Safecast/SolarcastNano/README.md

# Solarcast Nano

SCNano-1.0          Original Design files for Solarcast Nano 1.0 (PCB in Altium, Mechanical in Alibre)
