Safecast/SolarcastNano/step out/SCNano-Main3.DXF

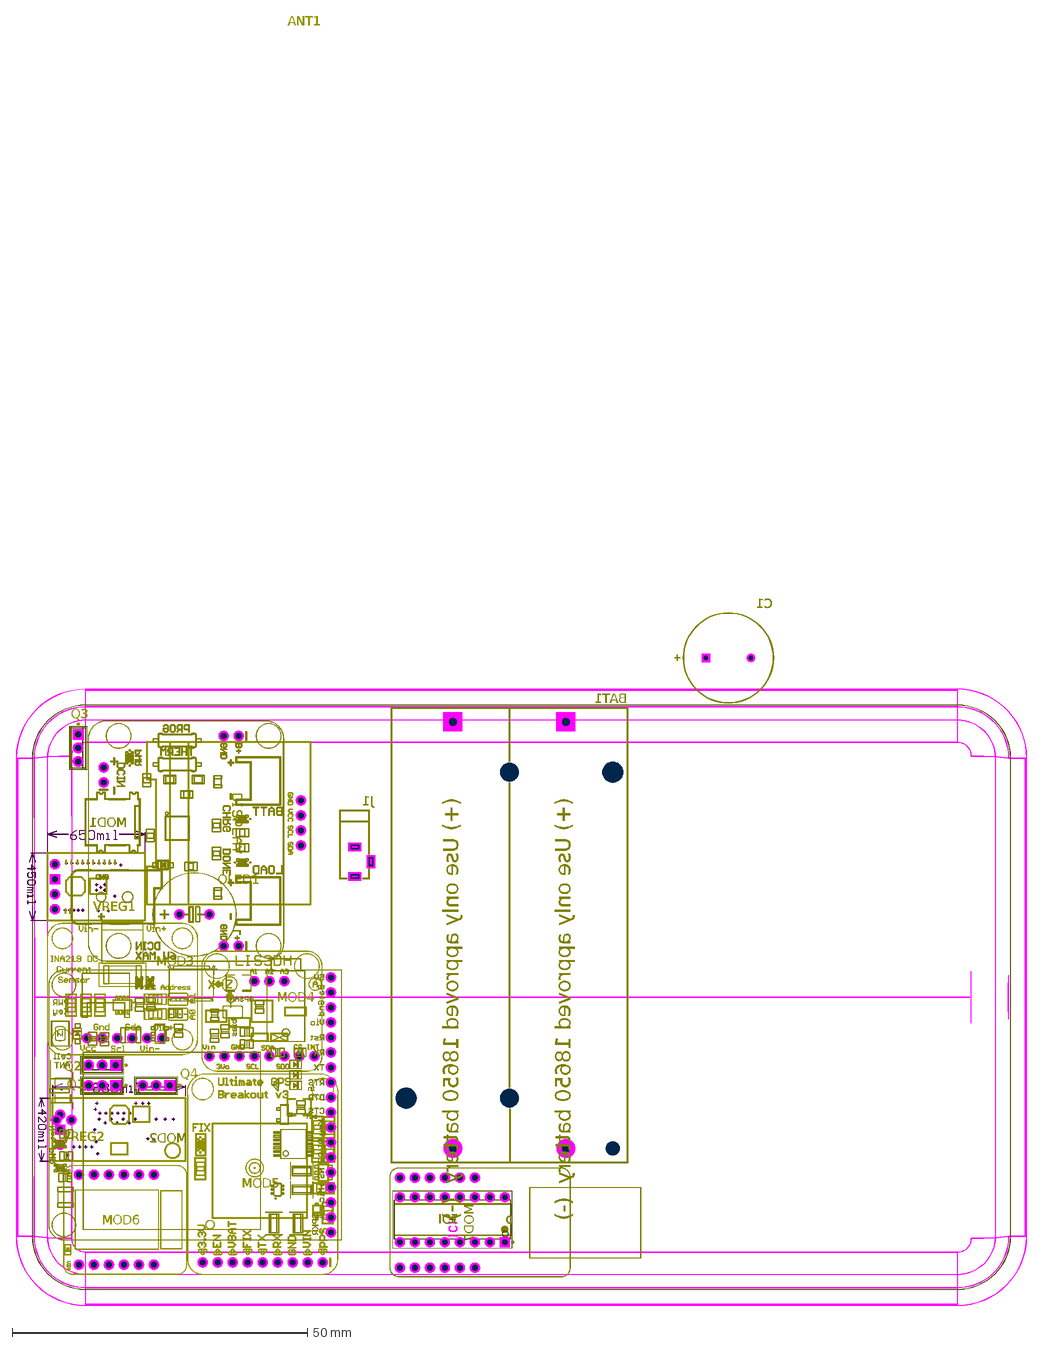
[picture p1: CAD file, 2017-12-16]
step out/SCNano-Main3.DXF
MOD7
MOD6
OLED1
VREG2
VREG1
Q4
Q3
Q2
Q1
MOD5
MOD3
MOD1
J1
IC1
(+) Use only approved 18650 battery (-)
BAT1
ANT1
MOD4
MOD2
C1
