Safecast/SolarcastNano/step/Voltatic/1.1W_6V_113x89mm_ASSEMBLY_CURRENT_2017_7_6.stp

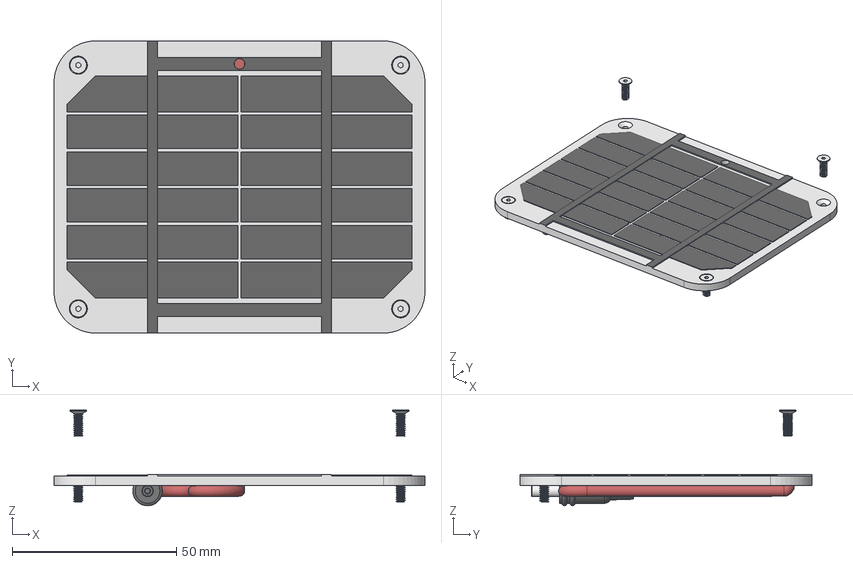
[picture p2: CAD file, 2017-12-16]
step/Voltatic/1.1W_6V_113x89mm_ASSEMBLY_CURRENT_2017_7_6.stp
113.0 x 89.0 x 29.1 mm
1.1W 6V 113x89mm PANEL CURRENT 2017 7 6
4-40 8mm SS316 Panel Screw x 4
3.2mm Wire (2 Bends)
M3511 Plug
