Safecast/SolarcastNano/step out/AD Base/GA Mount Plate.dxf

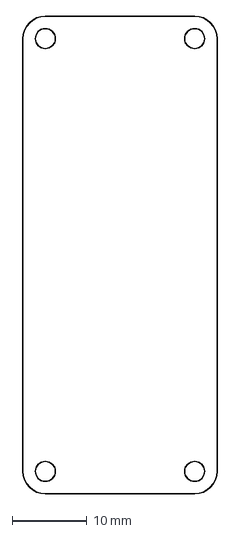
[picture p3: CAD file, 2017-12-16]
step out/AD Base/GA Mount Plate.dxf
26.0 x 64.0 mm
