Safecast/SolarcastNano/step out/CP1/SCNano-GeigCover.step

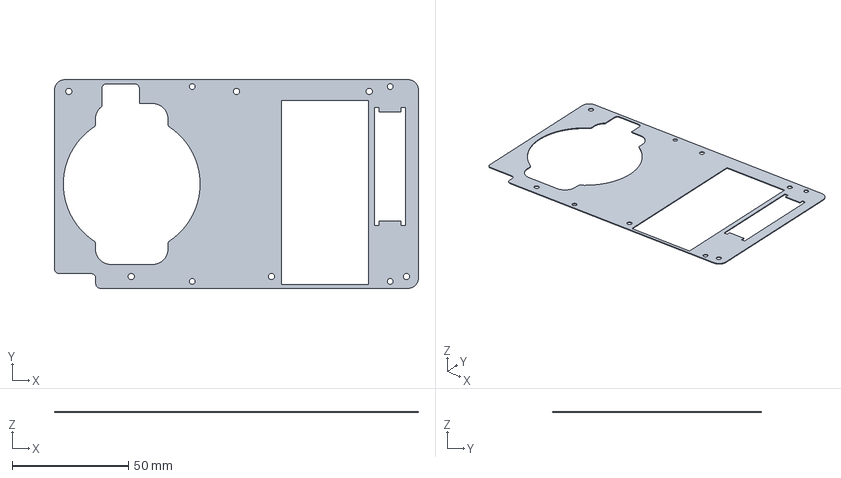
[picture p4: CAD file, 2017-12-16]
step out/CP1/SCNano-GeigCover.step
156.3 x 89.6 x 0.411 mm
