Safecast/SolarcastNano/step out/GB1/SCNano-GeigBase.step

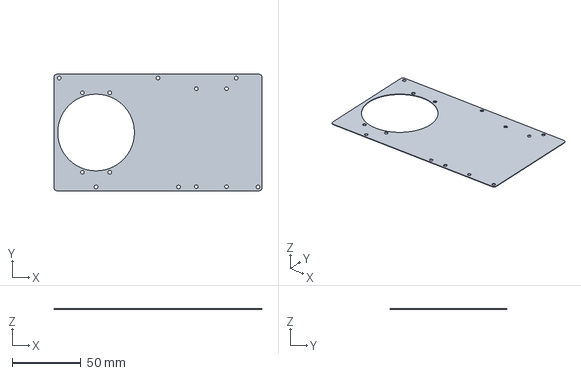
[picture p5: CAD file, 2017-12-16]
step out/GB1/SCNano-GeigBase.step
151.8 x 85.1 x 0.411 mm
