Safecast/SolarcastNano/step out/Rev A Drawings/Geiger Cover A.dxf

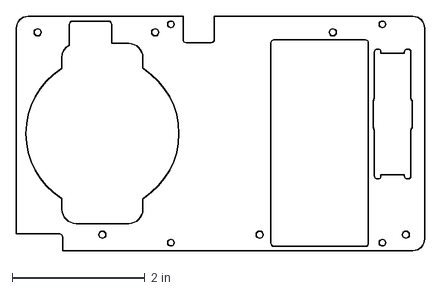
[picture p6: CAD file, 2017-12-16]
step out/Rev A Drawings/Geiger Cover A.dxf
6.15 x 3.53 in
