Safecast/SolarcastNano/step out/SCNano-GeigBase2.step

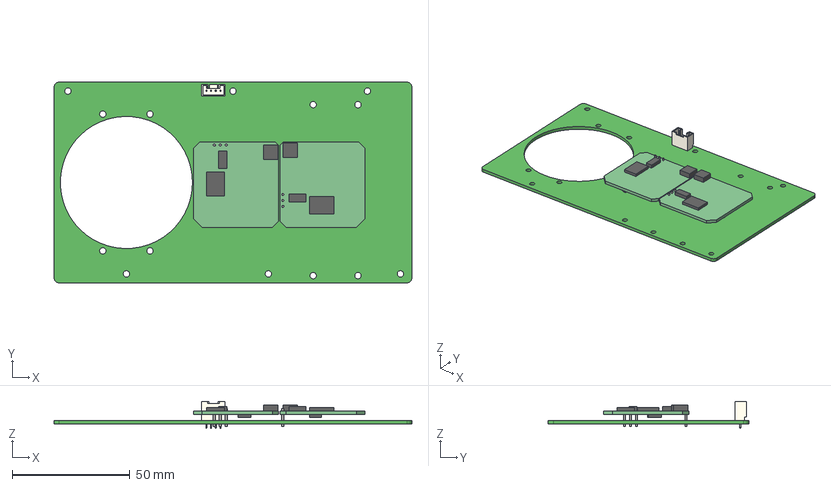
[picture p7: CAD file, 2017-12-16]
step out/SCNano-GeigBase2.step
151.8 x 85.1 x 11.6 mm
BoardGBase2
NSTech_1125S-4P
Extruded x 10
