Safecast/SolarcastNano/step/CUI PJ-031CH/pj-031ch.stp

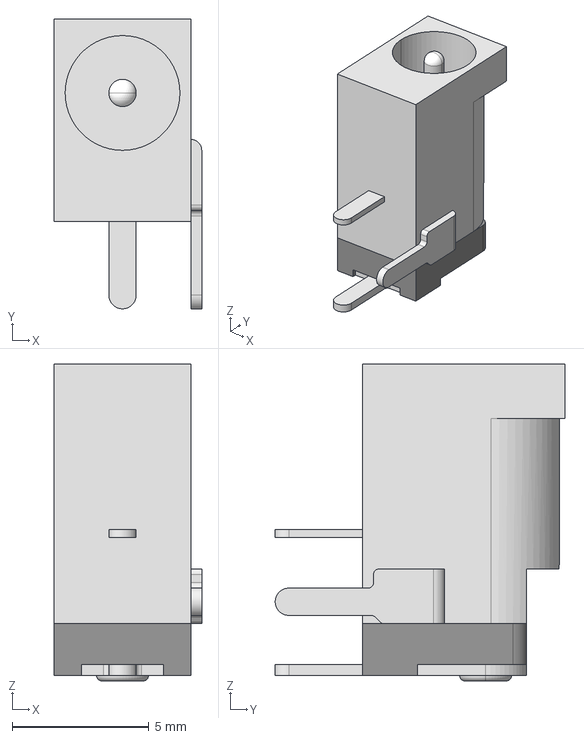
[picture p8: CAD file, 2017-12-16]
step/CUI PJ-031CH/pj-031ch.stp
5.40 x 10.6 x 11.6 mm
