Safecast/SolarcastNano/step/Headers/c-3-644457-5-e1-3d.stp

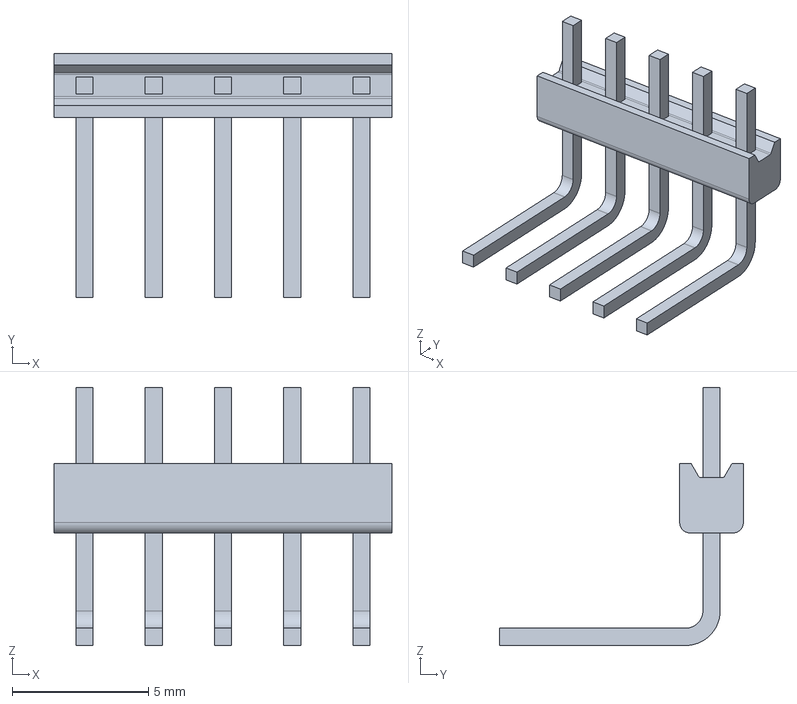
[picture p9: CAD file, 2017-12-16]
step/Headers/c-3-644457-5-e1-3d.stp
12.4 x 8.94 x 9.46 mm
