Safecast/SolarcastNano/step/Keystone 1049/keystone-PN1049.STEP

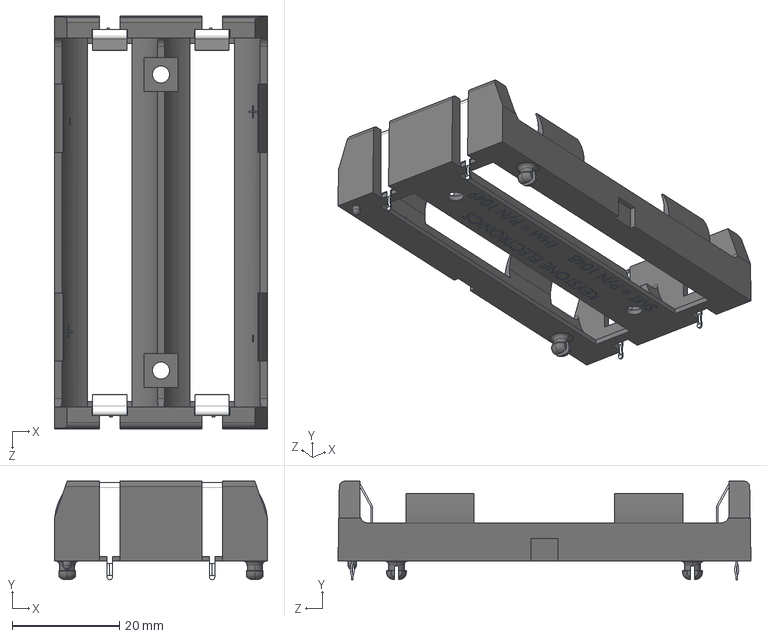
[picture p10: CAD file, 2017-12-16]
step/Keystone 1049/keystone-PN1049.STEP
39.8 x 18.4 x 77.1 mm
