Safecast/SolarcastNano/step/LND7318/Pancake 7318.stp

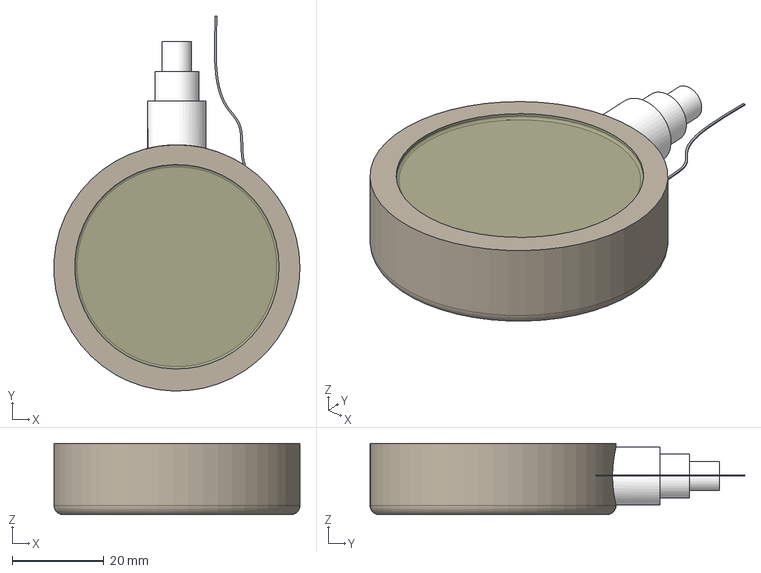
[picture p11: CAD file, 2017-12-16]
step/LND7318/Pancake 7318.stp
53.5 x 81.6 x 15.5 mm
