Safecast/SolarcastNano/step/Pelican 1040_step/1040_dxf/1040-case-top-1.DXF

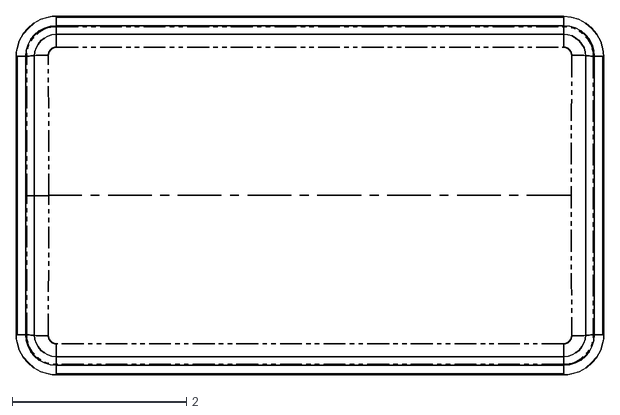
[picture p12: CAD file, 2017-12-16]
step/Pelican 1040_step/1040_dxf/1040-case-top-1.DXF
6.73 x 4.11
