Safecast/SolarcastNano/step/Pelican 1040_step/1040_step/1040_OEM_BTM.STEP

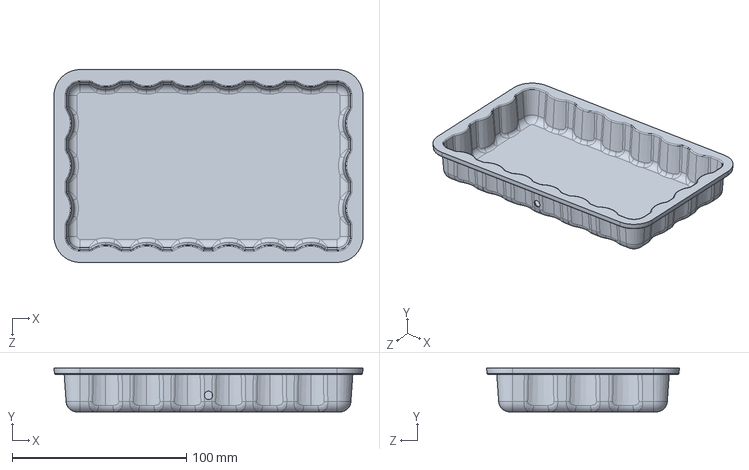
[picture p13: CAD file, 2017-12-16]
step/Pelican 1040_step/1040_step/1040_OEM_BTM.STEP
177.3 x 25.1 x 110.6 mm
