Safecast/SolarcastNano/step out/AD Base/GA Tube Plate.dxf

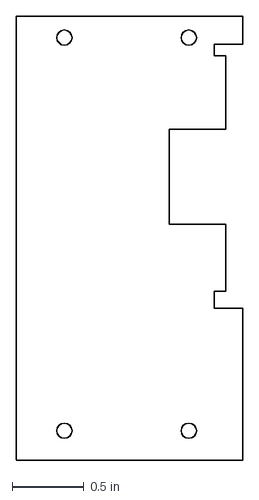
[picture p14: CAD file, 2017-12-16]
step out/AD Base/GA Tube Plate.dxf
1.57 x 3.09 in
