Safecast/SolarcastNano/step out/Rev A Drawings/Geiger Plate Rev A.dxf

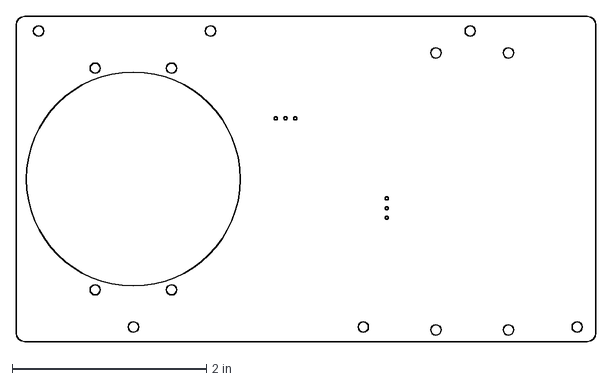
[picture p15: CAD file, 2017-12-16]
step out/Rev A Drawings/Geiger Plate Rev A.dxf
5.98 x 3.35 in
