Safecast/SolarcastNano/step/Headers/_ _ _C018SBAN-M71RC.STEP

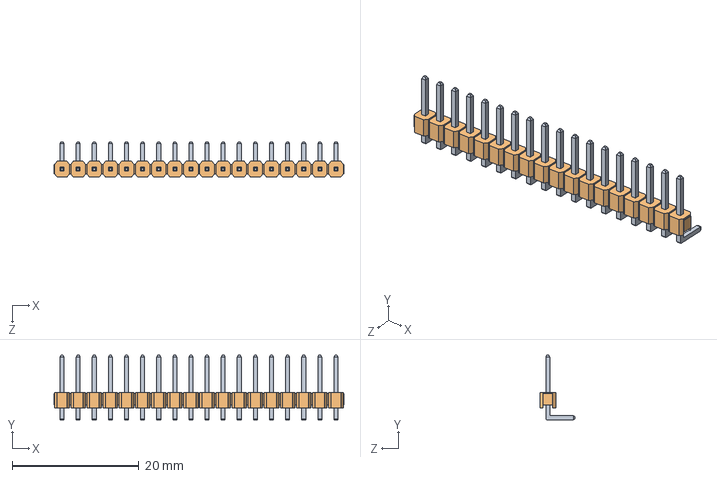
[picture p16: CAD file, 2017-12-16]
step/Headers/_ _ _C018SBAN-M71RC.STEP
45.7 x 10.2 x 5.59 mm
