Safecast/SolarcastNano/step/Pelican 1040_step/1040_step/1040-TOP-002.STEP

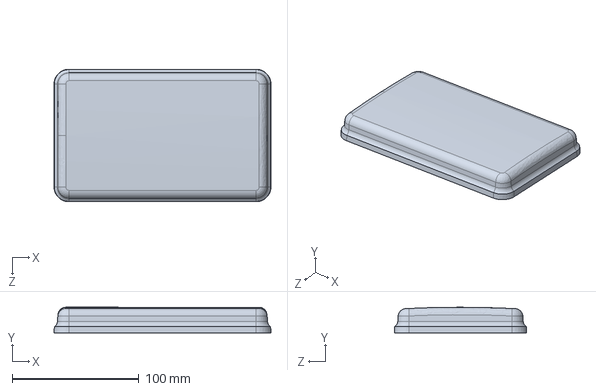
[picture p17: CAD file, 2017-12-16]
step/Pelican 1040_step/1040_step/1040-TOP-002.STEP
171.1 x 20.1 x 104.4 mm
