Safecast/SolarcastNano/step/Voltatic/Volatic Panel.dxf

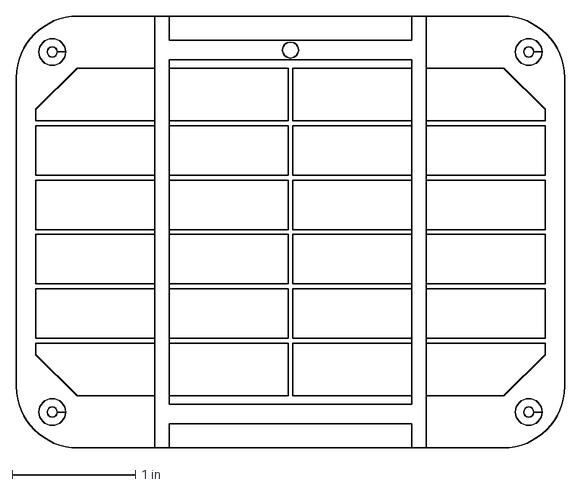
[picture p18: CAD file, 2017-12-16]
step/Voltatic/Volatic Panel.dxf
4.45 x 3.50 in
