Safecast/SolarcastNano/step out/AD Base/GA Protect Plate.dxf

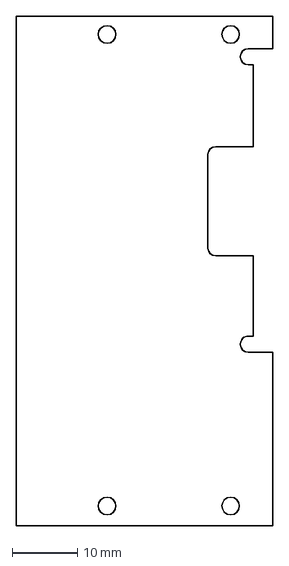
[picture p19: CAD file, 2017-12-16]
step out/AD Base/GA Protect Plate.dxf
39.5 x 78.4 mm
