Safecast/SolarcastNano/step out/SCNano-GeigCover1.step

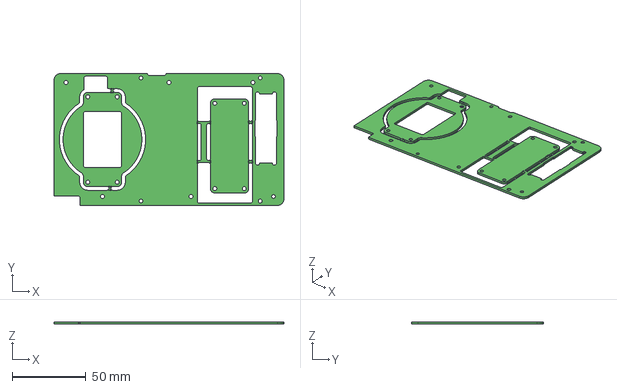
[picture p20: CAD file, 2017-12-16]
step out/SCNano-GeigCover1.step
156.3 x 89.6 x 1.53 mm
