Safecast/SolarcastNano/step/Headers/TLW-105-01-T-S-RA(0.495).stp

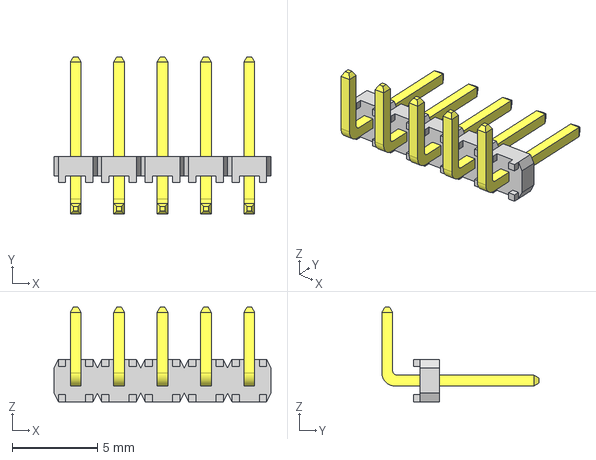
[picture p21: CAD file, 2017-12-16]
step/Headers/TLW-105-01-T-S-RA(0.495).stp
12.7 x 9.21 x 5.54 mm
_TLW-105-01-T-S-RA0.495_terminal
_TLW-05-01-S-RA
