Safecast/SolarcastNano/step/Voltatic/Voltaic1W.stp

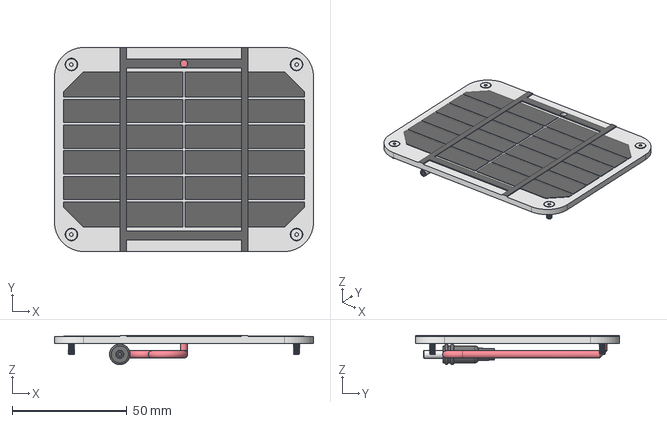
[picture p22: CAD file, 2017-12-16]
step/Voltatic/Voltaic1W.stp
113.0 x 89.0 x 12.8 mm
