Safecast/SolarcastNano/step out/AD Base/GA Tube Seat.dxf

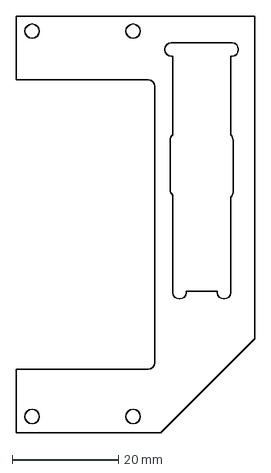
[picture p23: CAD file, 2017-12-16]
step out/AD Base/GA Tube Seat.dxf
44.9 x 78.4 mm
