Safecast/SolarcastNano/step/Headers/_ _ _C181LGBN-RC.STEP

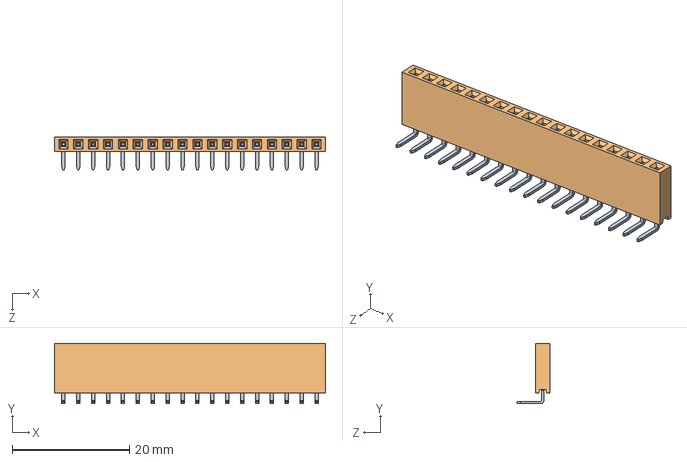
[picture p24: CAD file, 2017-12-16]
step/Headers/_ _ _C181LGBN-RC.STEP
46.2 x 10.3 x 5.69 mm
