Safecast/SolarcastNano/step out/AD Base/Antenna mount.dxf

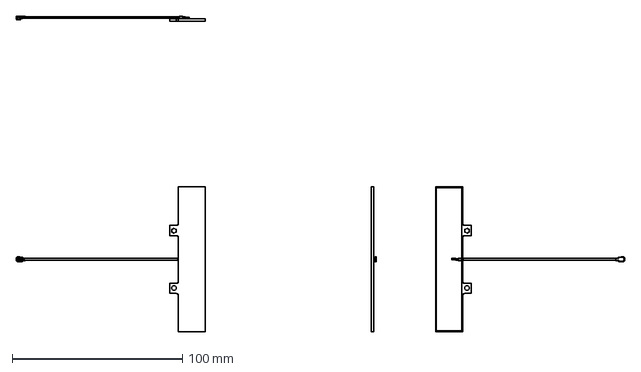
[picture p25: CAD file, 2017-12-16]
step out/AD Base/Antenna mount.dxf
357.2 x 185.2 mm
