Safecast/SolarcastNano/step/Headers/TLW-105-06-T-S(0.3).stp

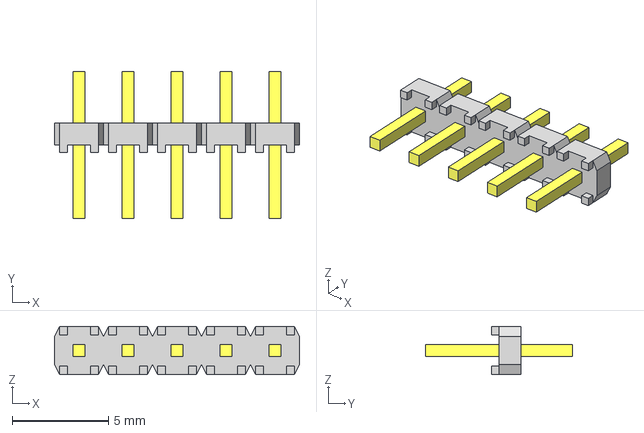
[picture p26: CAD file, 2017-12-16]
step/Headers/TLW-105-06-T-S(0.3).stp
12.7 x 7.62 x 2.49 mm
_TLW-105-06-T-S0.3_terminal
_TLW-05-06-S
