Safecast/SolarcastNano/step/Voltatic/M3511_Plug.stp

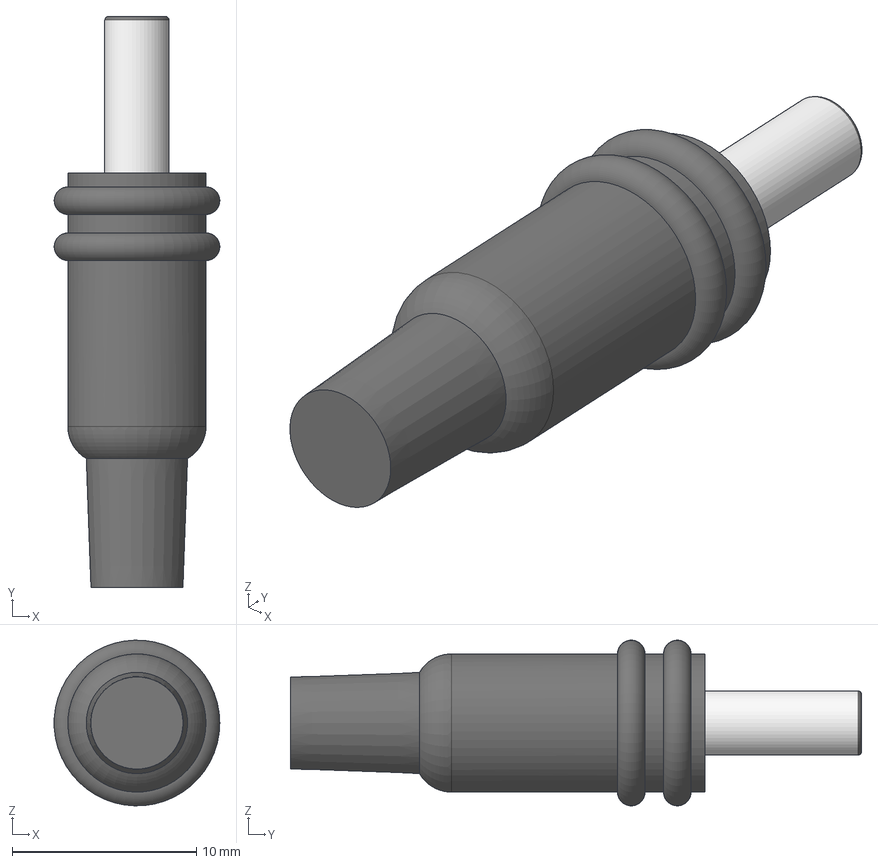
[picture p27: CAD file, 2017-12-16]
step/Voltatic/M3511_Plug.stp
8.99 x 31.0 x 9.00 mm
