Safecast/SolarcastNano/step out/AD Base/GA Base Plate.dxf

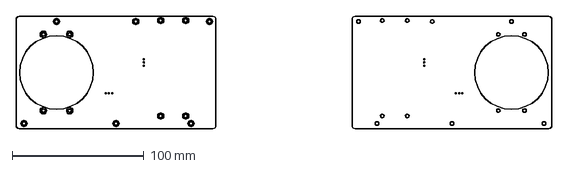
[picture p28: CAD file, 2017-12-16]
step out/AD Base/GA Base Plate.dxf
407.2 x 85.1 mm
