Safecast/SolarcastNano/step/Headers/_ _C06SFCN.STEP

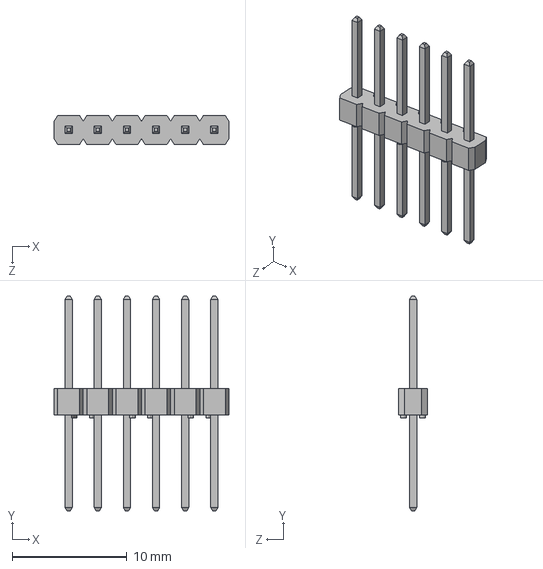
[picture p29: CAD file, 2017-12-16]
step/Headers/_ _C06SFCN.STEP
15.2 x 18.7 x 2.54 mm
