Safecast/SolarcastNano/step out/AD Base/Pancake 7318.dxf

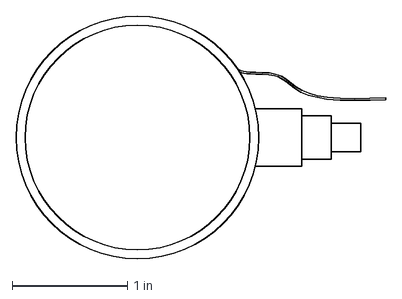
[picture p30: CAD file, 2017-12-16]
step out/AD Base/Pancake 7318.dxf
3.21 x 2.11 in
