Safecast/SolarcastNano/step out/AD Base/GA Tube Seat and tube.dxf

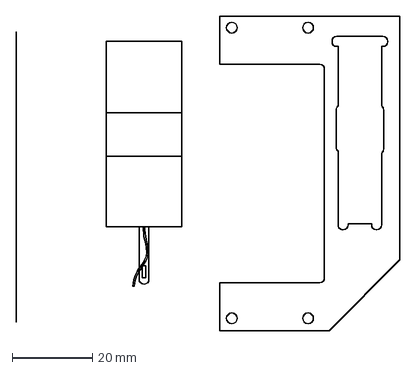
[picture p31: CAD file, 2017-12-16]
step out/AD Base/GA Tube Seat and tube.dxf
95.7 x 78.4 mm
