Safecast/SolarcastNano/(list of files, cad)

Other CAD files:
step/CUI PJ-031CH/pj-031ch.dxf
step/Molex 1461850100/1461850100.stp
step/Voltatic/Volatic Panel T-Nut.stp
step/fasteners/screws/91801A135_METRIC 316 SS FLAT HEAD PHIL MACHINE SCREW M2.5 6mm.STEP
step/fasteners/screws/92005A066_METRIC M2.5x6mm PAN HEAD PHILLIPS MACHINE SCREW.STEP
step/fasteners/standoff/94868A170_18-8 SS FEM THRDED HEX STANDOFF.STEP
step/fasteners/standoff/95947A001_ALUM FEM THRDED HEX STANDOFF 6mm M2.5.STEP
step/fasteners/standoff/95947A003_ALUM FEM THRDED HEX STANDOFF 8mm M2.5.STEP
step/fasteners/standoff/95947A011_ALUM FEM THRDED HEX STANDOFF 16mm M2.5.STEP
step/fasteners/standoff/essentra richco/EHCS-8-01 (14662).stp
step/fasteners/standoff/essentra richco/MDLSP1-05M-01.igs
step/fasteners/standoff/essentra richco/MDLSP1-05M-01.stp
step/fasteners/standoff/essentra richco/MDLSP1-14M-01.stp
step/fasteners/standoff/essentra richco/TCEHCBS-8-01.stp
step/fasteners/standoff/heyco-10939.stp
