Safecast/SolarcastNano/step/fasteners/standoff/essentra richco/EHCBS.pdf

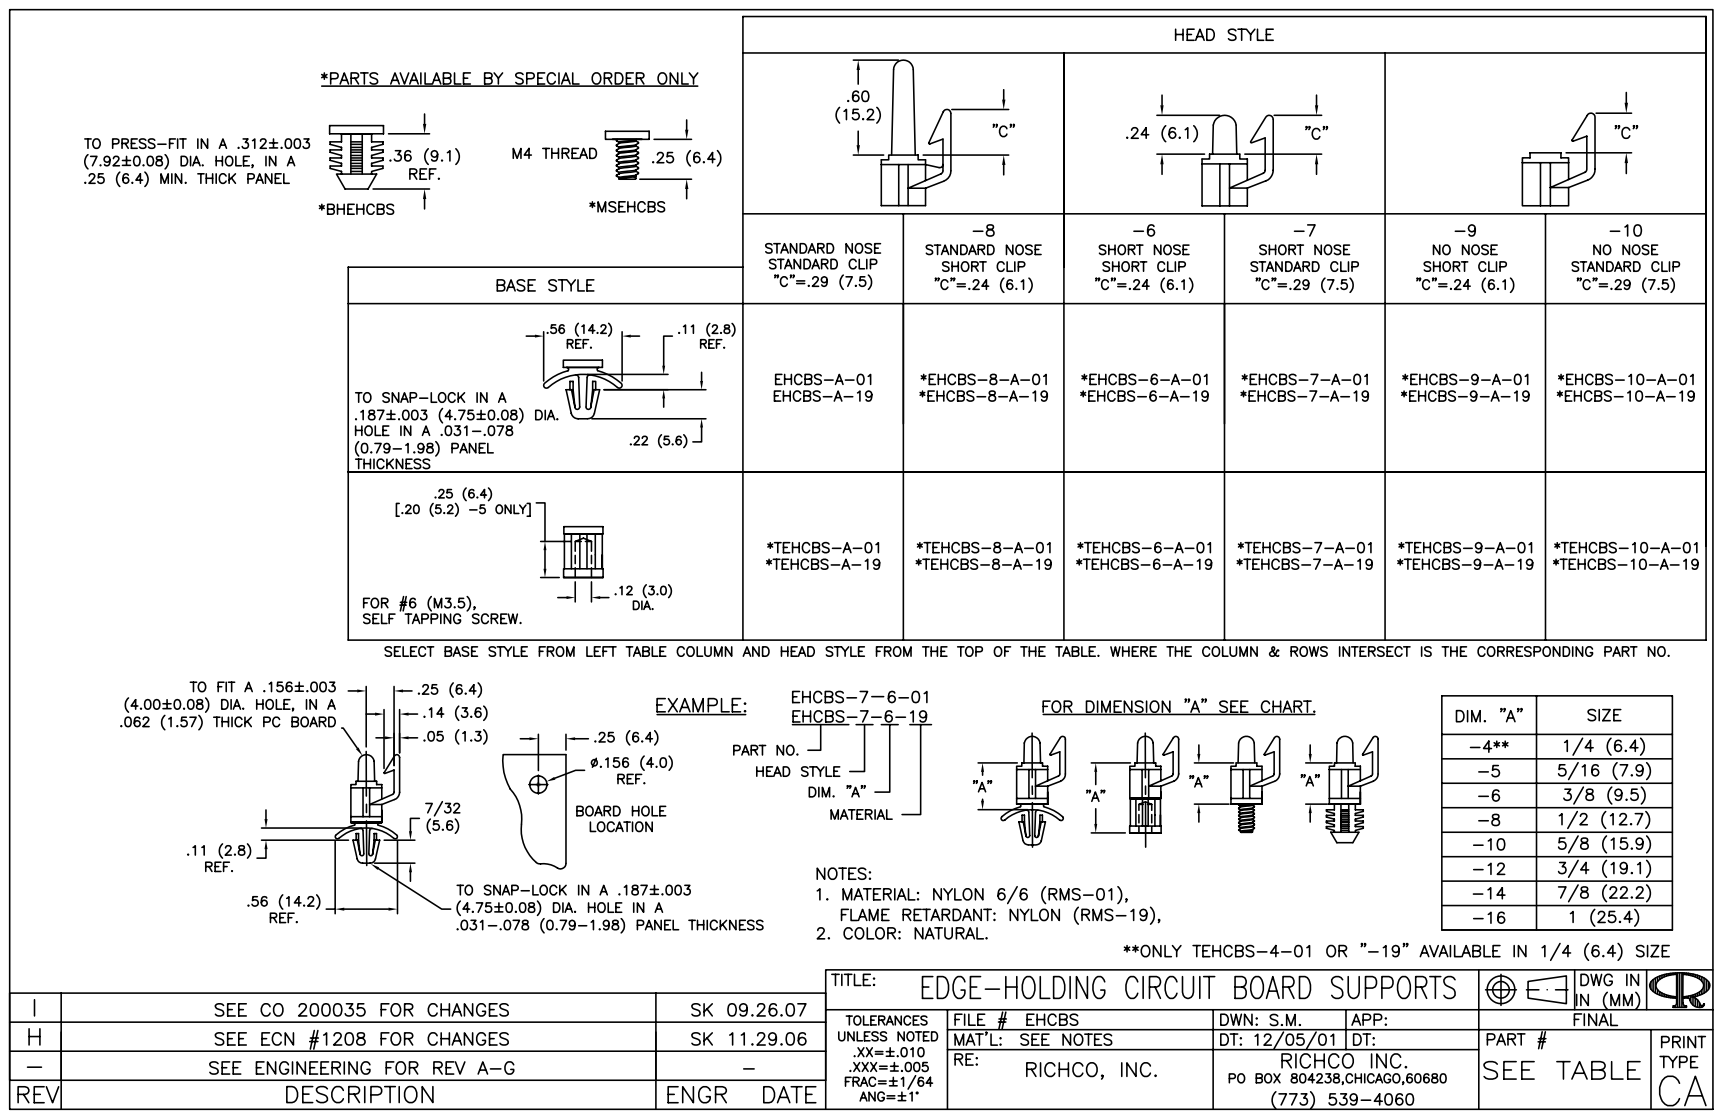
[picture p32: page 1]
