Safecast/SolarcastNano/step/fasteners/standoff/essentra richco/TCEHCBS.pdf

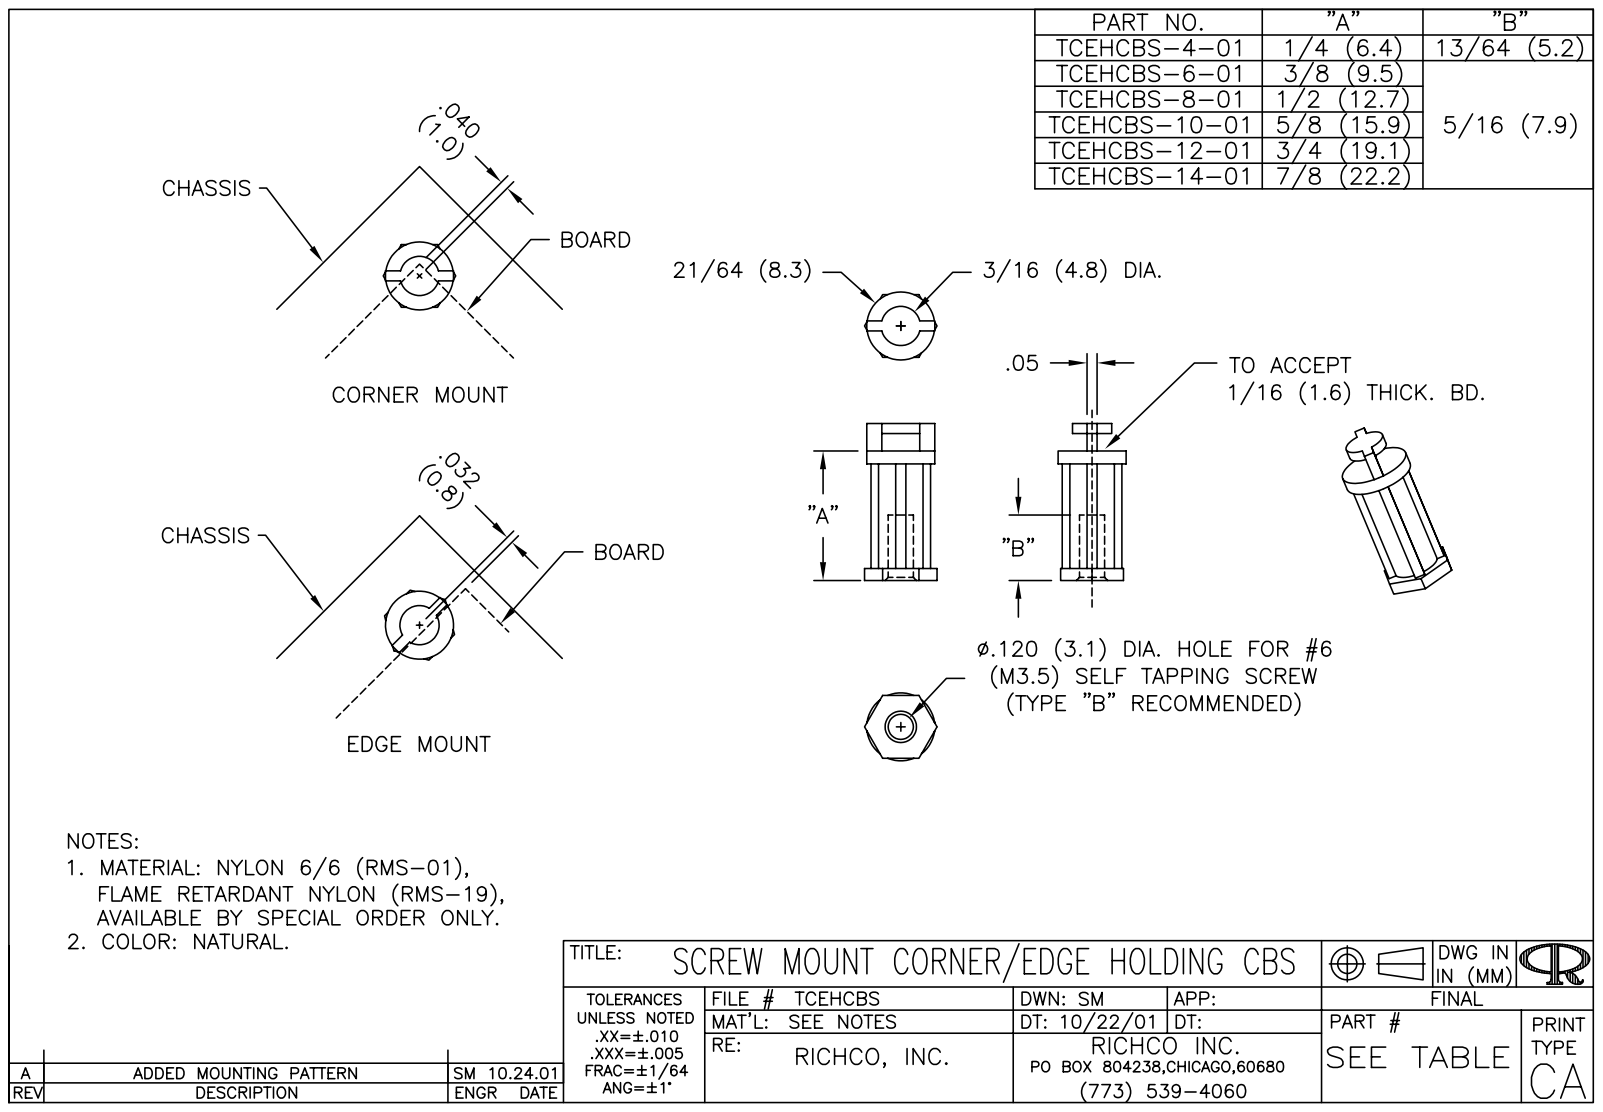
[picture p33: page 1]
