Safecast/SolarcastNano/(list of files, drawings)

Other design files:
SCNano-Geig.SchDoc
SCNano-GeigAssyParts.PcbDoc
SCNano-lib.PcbLib
scnano-lib.SchLib
SCNano-Main.SchDoc
