Safecast/SolarcastNano/kicad/SCNano-Main-PcbDoc.kicad_pcb

## KiCad design kicad/SCNano-Main-PcbDoc.kicad_pcb (2017-12-18)

Schematic: SCNano-Main-SchDoc.sch

Parts:
ANT1: 3G Antenna
BAT1: KEYSTONE_1049
BOM1: Battery - 1of 2
BOM2: Battery - 2 of 2
C1: CAP POL RB13-25
CON1: SC_CON_GEIGIE_4PIN
IC1: SN74LV4052A
J1: (no value)
MOD1: LiPo Charger
MOD2, MOD2_2: FONA 3G
MOD3: Current Sensor
MOD4: 3-Axis
MOD5: GPS
MOD6: Nano V2
MOD7: DAPLink 1.5
MOD8: MicroUSB
OLED1: OLED 128x64
Q1, Q2, Q3, Q4: STU85N3LH5
SOLARPANEL1: VOLTAIC_SOLAR_PANEL_1W
SW1: SW-DPDT
VREG1: Regulator 3.3V
VREG2: Regulator Variable

Connections:
3V3: CON1.2 (RED(3V3)), IC1.16 (VCC), MOD2.4 (Vio), MOD2.5 (RST(Reset)), MOD3.1 (Vcc), MOD4.2 (3Vo), MOD5.8 (VIN), MOD6.2-1 (VDD(3.3V)), MOD7.2-1 (VDD/+3.3Vout), OLED1.1 (VCC), VREG1.1 (VOUT)
/BAT-BUS: MOD1.3 (B+), MOD3.5 (Vin-), VREG1.3 (VIN), VREG2.1 (VIN)
/BAT-POS: BAT1.1 (+), BAT1.3 (+), SW1.1
/BAT-SW: MOD3.6 (Vin+), SW1.2
/ENABLE-CELL: IC1.9 (B), MOD6.3-4 (P08), Q1.1 (G)
/ENABLE-GEIG: MOD6.3-1 (P03), Q3.1 (G)
/ENABLE-GPS: IC1.10 (A), MOD6.3-3 (P07), Q4.1 (G)
/ENABLE_TWI: MOD6.3-2 (P06), Q2.1 (G)
/FONA-BAT: MOD2.2 (Battery), VREG2.3 (VOUT)
/FONA-RX: IC1.2 (2Y2), MOD2.6 (RX)
/FONA-TX: IC1.15 (1Y2), MOD2.7 (TX)
/GEIGER0: CON1.4 (YEL(GEIGER0)), MOD6.1-4 (P04), MOD7.1-4 (NC[P04])
/GEIGER1: CON1.3 (WHT(GEIGER1)), MOD6.1-3 (P05), MOD7.1-3 (NC[P05])
/GND-CELL: MOD2.3 (GND), MOD2.11 (Key), Q1.2 (D), VREG2.2 (GND)
/GND-GEIG: CON1.1 (BLK(GND)), Q3.2 (D)
/GND-GPS: MOD5.7 (GND), Q4.2 (D)
/GND-TWI: MOD3.2 (Gnd), OLED1.2 (GND), Q2.2 (D)
/LIS-INT: MOD4.8 (INT), MOD6.3-5 (P21)
/MCU-RX: IC1.13 (1-COM), MOD6.2-4 (N2:RX/P30), MOD7.2-4 (DL:TXD[P30])
/MCU-SWCLK: MOD6.1-1 (DCLK), MOD7.1-1 (SWDCLK)
/MCU-SWDIO: MOD6.1-2 (DIO), MOD7.1-2 (SWDIO)
/MCU-TX: IC1.3 (2-COM), MOD6.2-3 (N2:TX/P29), MOD7.2-3 (DL:RXD[P29])
/NANO_VIN: MOD6.1-6 (VIN(USB5V)), MOD7.1-6 (VIN/USB5V)
/PANEL-POS: J1.1, MOD1.1 (DCIN+[TB1]), MOD8.5 (5V)
/TWI-SCL: MOD3.3 (Scl), MOD4.4 (SCL), MOD6.2-5 (N2:RTS/P02), MOD7.2-5 (DL:CTS[P31]), OLED1.3 (SCL)
/TWI-SDA: MOD3.4 (Sda), MOD4.5 (SDA), MOD6.2-2 (N2:CTS/P28), MOD7.2-2 (DL:RTS[P28]), OLED1.4 (SDA)
/UGPS-RX: IC1.5 (2Y1), MOD5.6 (RX)
/UGPS-TX: IC1.14 (1Y1), MOD5.5 (TX)
GND: BAT1.2 (-), BAT1.4 (-), C1.2, IC1.6 (INH), IC1.7 (GND), IC1.8 (GND), J1.2, MOD1.2 (DCIN-[TB1]), MOD1.4 (GND), MOD1.6 (C4-/GND), MOD1.8 (GND), MOD4.3 (GND), MOD6.1-5 (GND), MOD6.2-6 (GND), MOD7.1-5 (GND), MOD7.2-6 (GND), MOD8.1 (GND), Q1.3 (S), Q2.3 (S), Q3.3 (S), Q4.3 (S), VREG1.2 (GND)
unnamed: C1.1, MOD1.5 (C4+)

Notes on the sheet:
=sheetnumber
=organization
=address1
=address2
=address3
=address4
=sheettotal
=title
=documentnumber
=revision
=CurrentDate
=CurrentTime
=DocumentFullPathAndName
Title
Size:
Number:
Date:
File:
Revision:
Sheet
Time:
>>> Cable to Geiger Board
Note: USB A(F)/Micro-B(M) Retractable Cable
FET0
FET1
FET2
FET3
Note: Misc. Headers, Hardware
Note: Enclosure: Pelican 1040, modified with circular cutout and mylar film.
Power In
Charge Monitoring
OLED Display
3-Axis sensor
Microprocessor
Programming Interface
Connection to Geiger Board
TWI Bus
GPS
3G Data
3.3V Regulator (System Power)
4V Regulator (3G Module Power)
Miscellaneous Items
Serial Data Multiplexing
Note: Fona: Install SIM Card in module.
Note: Fona: Choose the correct module for North America vs. Asia/Europe 3G GSM operation
Note: GPS module: Do not install coin bat
Note: GPS module: We are intentionally skipping onboard regulator by powering via 3v3 pin
Note: INA219 - Use default address, do not install terminal block
Note: LIS3DH: Be sure to remove the SDA pull-up resistor.
Note: Grove 4-pin cable connects mainboard to geiger assembly.
Note: Charger Module: Do not install 4,700uF CAP on module. Instead, mount it on SCNano mainboard.
18 pin socket for FONA 3G: Sullins PPTC181LGBN-RC
5 pin RA TH Header For Nano V2 - TE 3-644457-5
4x Nuts for space under solar panel McMaster 90480A005
2x Sullins PEC06SFCN long-tailed header for NanoV2
4x board spacer between main board and geig assy top: MDLSP1-14M-01
Note: NanoBear Alignment Fixture: Use alignment fixture to attach 5-pin R/A header to the RedBear Nano
ToDo: Improved Pancake Tape Alignment Fixture
Note: Power Nets are designed for 1A with 2A spike. IPC calculator yielded 80 mil trace for 4A current
18 pin header for FONA 3G: Sullins PREC018SBAN-M71RC
3.9-4.2V into 10K Ohm
2x board spacer between main board and antenna holder : MDLSP1-5M-01
Note: Fona: Consult instructions for 9600 bps operation.
4x board spacer between main board and solar panel: 36-8829-ND (Keystone 8829)
Optional - keying plugs for header socket: 104072-1 (10 per unit)
Net Class
Power

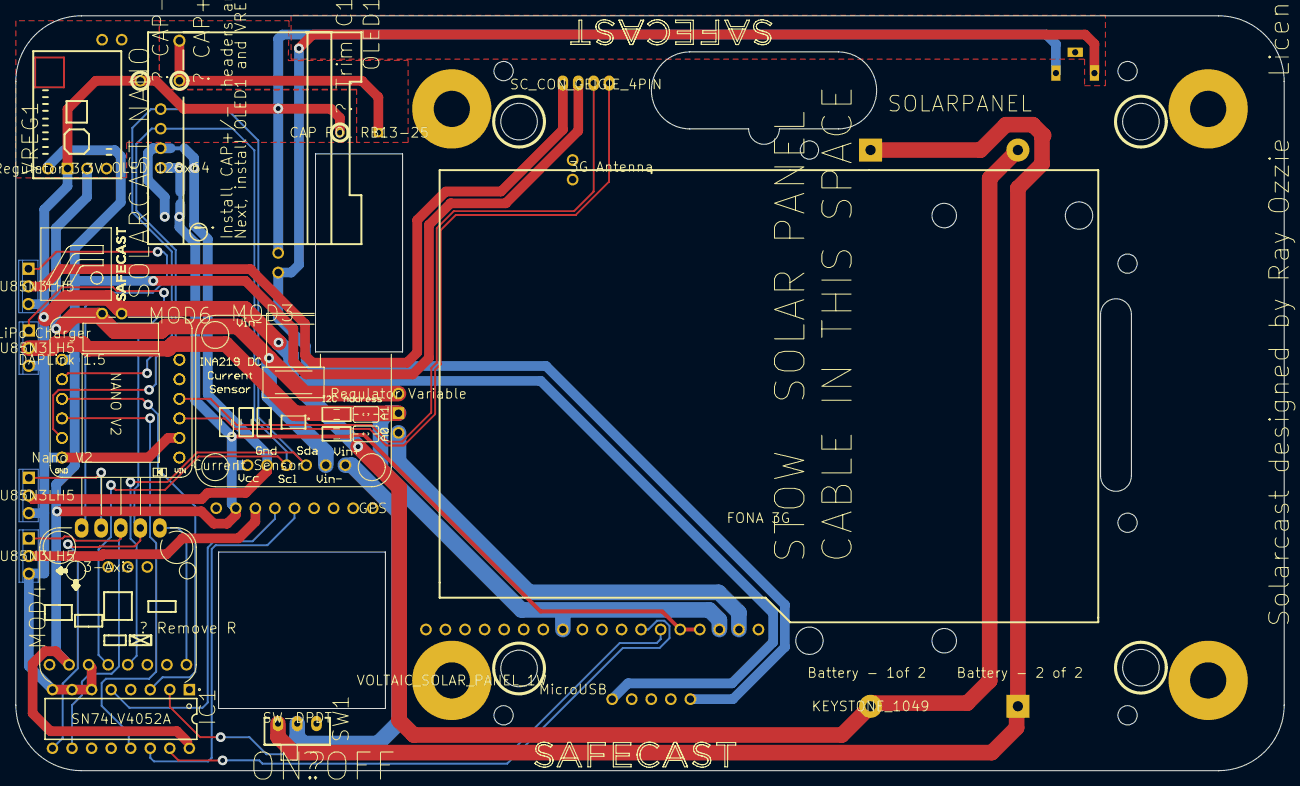
[picture p34: board SCNano-Main-PcbDoc.kicad_pcb from above]

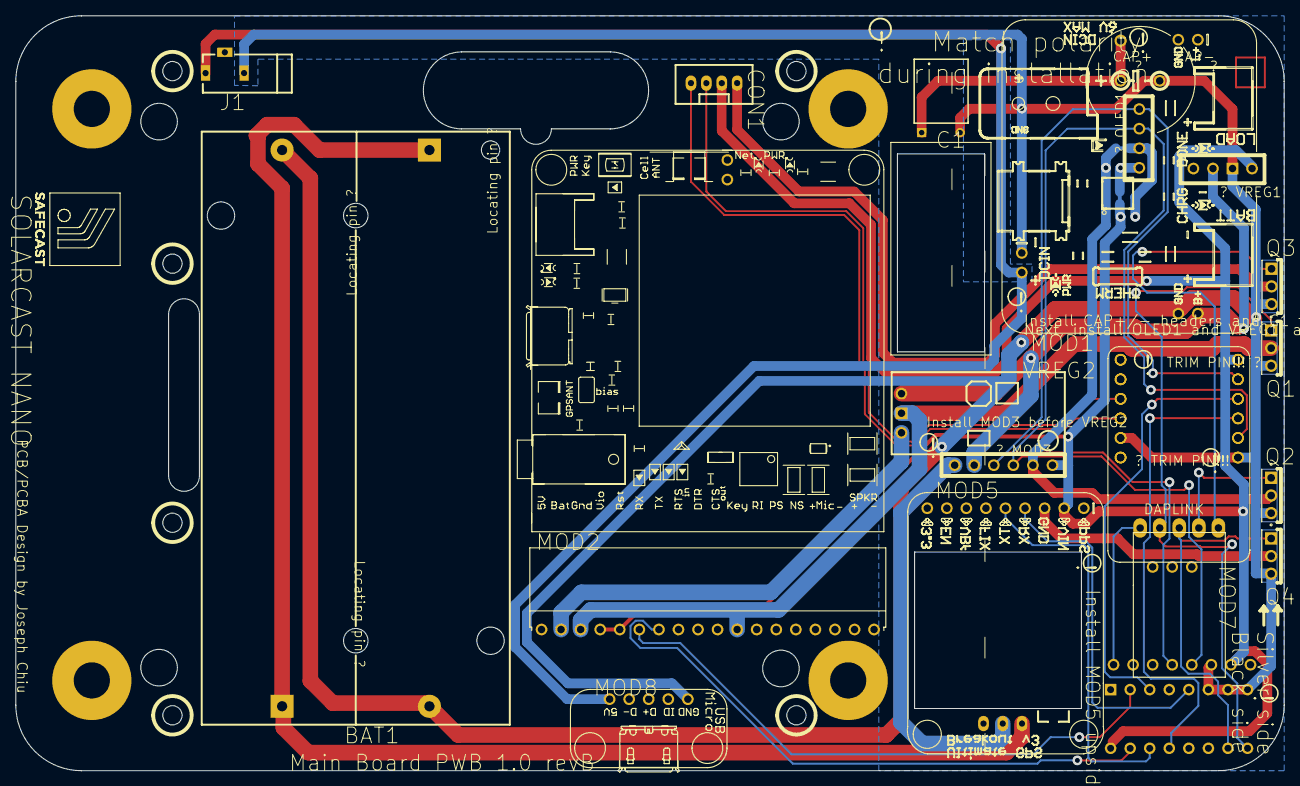
[picture p35: board SCNano-Main-PcbDoc.kicad_pcb from below]

Board: 2 copper layers, 164.7 x 98.0 mm, 25 parts (17 on the bottom side), 30 nets.
