Safecast/SolarcastNano/(commit log)

2017-12-16 Initial checkin
    [1.1W_6V_113x89mm_ASSEMBLY_CURRENT_2017_7_6.stp, 1040-TOP-002.STEP, 1040-case-top-1.DXF, 1040_OEM_BTM.STEP, 1461850100.stp, 91801A135_METRIC 316 SS FLAT HEAD PHIL MACHINE SCREW M2.5 6mm.STEP, 92005A066_METRIC M2.5x6mm PAN HEAD PHILLIPS MACHINE SCREW.STEP, 94868A170_18-8 SS FEM THRDED HEX STANDOFF.STEP]
2017-12-16 Initial KiCAD conversion of PCB
    [SCNano-Main-PcbDoc.kicad_pcb]
2017-12-18 Work in progress - conversion to KiCAD. There are still known problems in the conversion.
    [SCNano-Main-PcbDoc.kicad_pcb, SCNano-Main-SchDoc.sch]
2017-12-18 Remove alternate-mode symbols in RedBear Altium schematic symbols to prevent overlapped symbols in converted KiCAD schematic
    [SCNano-Main-SchDoc.sch, SCNano-Main.SchDoc, scnano-lib.SchLib]
2017-12-18 Some more fixes for symbol related issues
    [SCNano-Main-PcbDoc.kicad_pcb, SCNano-Main-SchDoc.sch, SCNano-Main.SchDoc, scnano-lib.SchLib]
2017-12-18 Altium Class Name directives are unsupported in KiCAD. The conversion process placed the same ClassName directives as labels, which caused multiple nets to be treated as the same net. Changed those l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
    [SCNano-Main-PcbDoc.kicad_pcb, SCNano-Main-SchDoc.sch]
