Safecast/SolarcastNano/(notices)

Notices in the files:
kicad/SCNano-Main-PcbDoc.kicad_pcb:
Solarcast designed by Ray Ozzie Licensed CC BY-SA 3.0 safecast.org
